moonblade/Water-level-indicator/README.md

# Water level indicator

[https://moonblade.github.io/blog/2021/09/11/over-engineering.html](https://moonblade.github.io/blog/2021/09/11/over-engineering.html)

A nodemcu tied to an ultrasonic sensor detects the distance to the water level at every ten seconds and uploads it to a firebase realtime db.

Android app, takes data from this db, and calculates current percentage based on min and max values it can have. Outlier values are discarded.

The app widget didn't really function as I wanted it to, so took a second nodemcu and created a water level indicator that takes data from firebase rtdb and displays it on an led matrix.

As an experiment in 3d printing and pcb printing, added eagle board schematic to print the water level indicator on pcb. Will end up removing the indicator and wire it up to relays to auto control the motor when water level is low.

### Update 2021-09-05

Bought a waterproof ultrasonic sensor, but the version supplied by the manufactorer seems to have some faults. One the minimum distance is too high and two it was giving random readings and not accurate ones. Which makes it unusable for this project. So ended up buying a new normal ultrasonic sensor and gave the waterproof one for return. But to learn previous lessons, figured would keep the sensor on top of the lid this time around so that corrosion doesn't play that big a role and it would be impossible for it to fall into water.

To that end, drilled a couple of holes in the lid of the water tank and stuck the sensor through it covering most of it with insulation tape. Also overhauled the microchip so that its easily replacable and works directly off of ac power doing its own coversion instead of relying on a phone charger.

Old vs new


Underside of lid


Topside connected up


### Update 2021-09-01 

The water level sensor was connected to the lid of hte water tank by threading it through the lid. The thread broke and the full box took a dip in the water and fried the electronics.
Till then it was getting a ton of water droplets on it due to evaporation as well. So the board looks really gnarly due to that.

For the updated version, will be using waterproof ultrasonic sensor and the ic will be kept seperate and not inside the lid anymore.



## Arduino code

### WaterLevelIndicator

Take data from firebase rtdb and display it on an 8x8 LED matrix based on value of printMode.





Installed in kitchen


### WaterLevelSensor

Get distance to water level and upload it to firebase rtdb.

Installed on the underside of the water tank lid. Had to do some rewiring of the electrical connections in the roof to provide uninterupted power bypassing a switch.


## App Screenshots

main
