moonblade/Water-level-indicator/screenshots/main.jpg

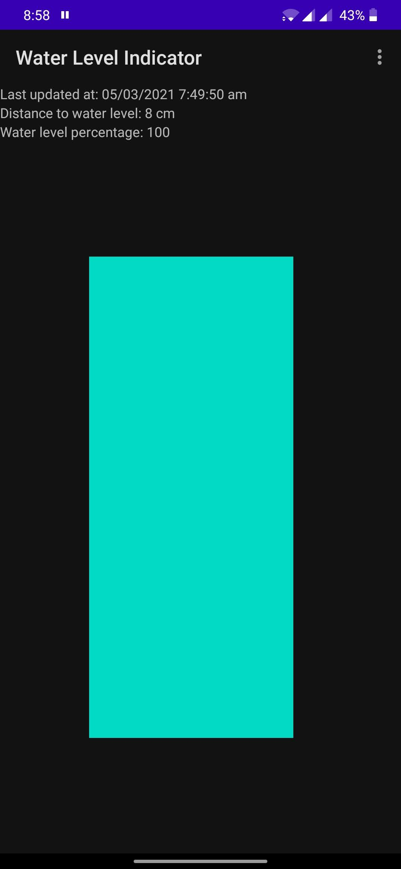
screenshots/main.jpg
