moonblade/Water-level-indicator/screenshots/settings.jpg

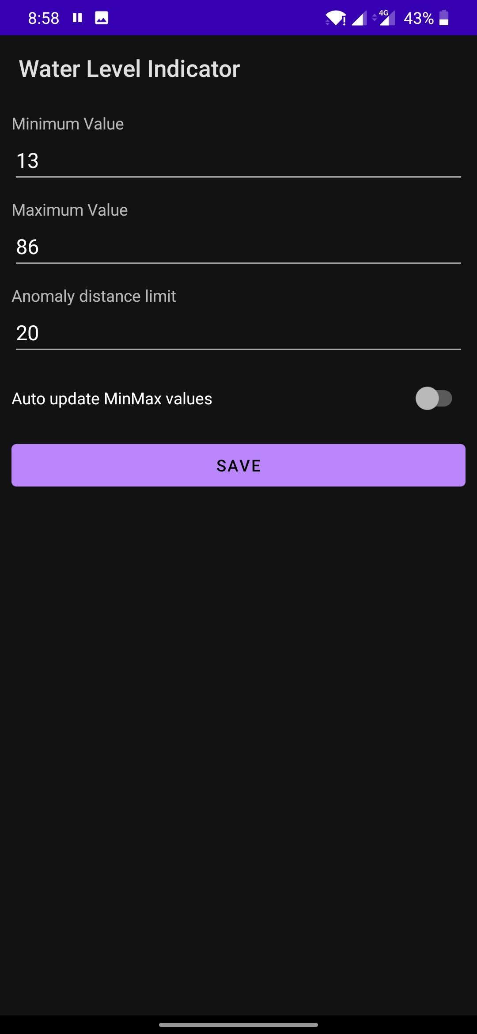
screenshots/settings.jpg
