moonblade/Water-level-indicator/eagle/WaterLevelIndicator.brd

## EAGLE design eagle/WaterLevelIndicator.brd (2021-05-04)

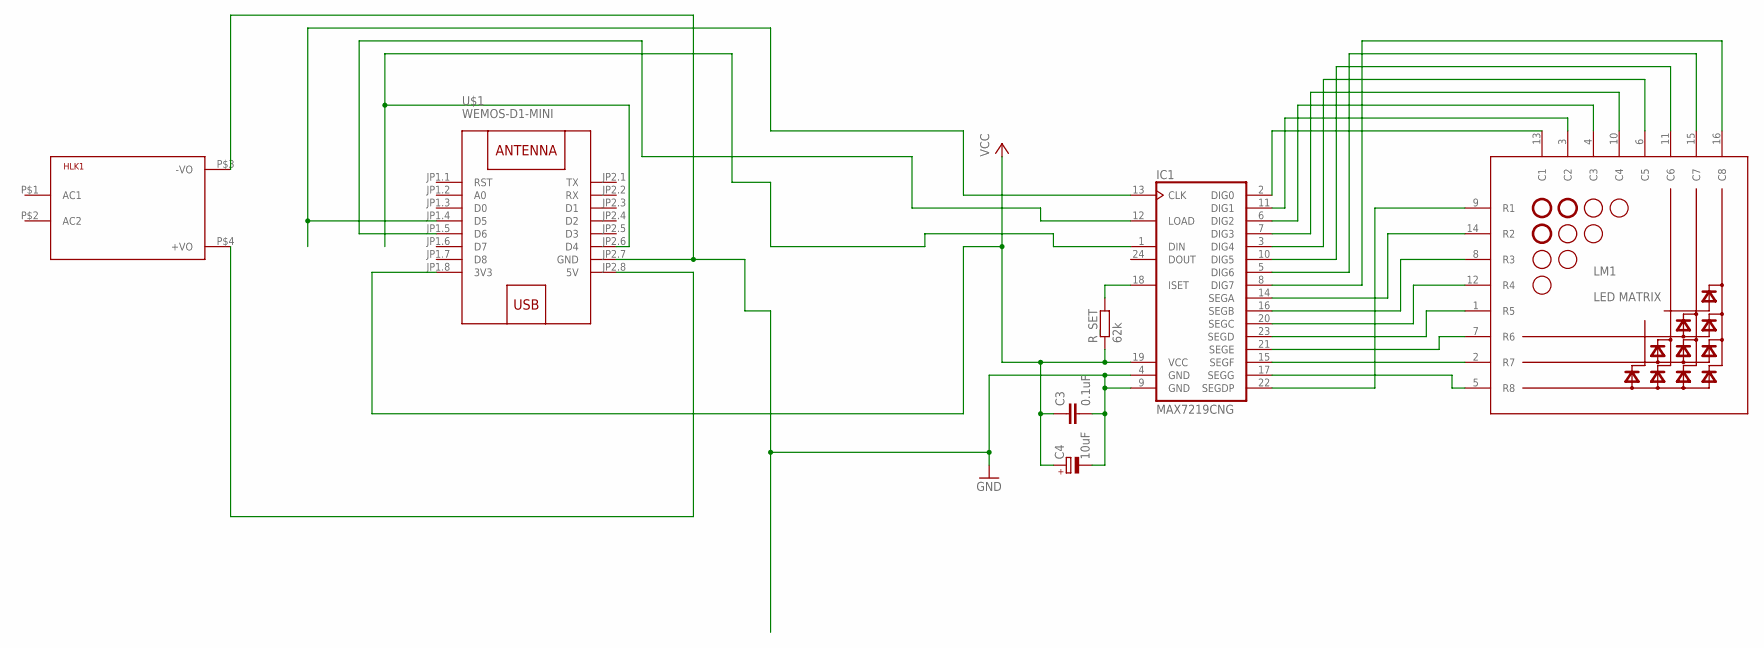
[picture p3: schematic WaterLevelIndicator.sch]

Parts:
C3: 0.1uF; C025-024X044
C4: 10uF; E2-5
HLK1: HLK-PM013W; HLK-PM01
IC1: MAX7219CNG; DIL24-3
LM1: LED MATRIX; LED_MATRIX
R_SET: 62k; 0207/10
U$1: WEMOS-D1-MINI

Connections:
GND: C3.2, C4.-, HLK1.P$3 (-VO), IC1.4 (GND), IC1.9 (GND), U$1.JP2.7 (GND)
unnamed: HLK1.P$4 (+VO), U$1.JP2.8 (5V)
unnamed: IC1.15 (SEGF), LM1.2 (R7)
unnamed: IC1.1 (DIN), U$1.JP2.6 (D4)
unnamed: IC1.12 (LOAD), U$1.JP1.5 (D6)
unnamed: IC1.13 (CLK), U$1.JP1.4 (D5)
unnamed: IC1.21 (SEGE), LM1.7 (R6)
unnamed: IC1.23 (SEGD), LM1.1 (R5)
unnamed: IC1.20 (SEGC), LM1.12 (R4)
unnamed: IC1.16 (SEGB), LM1.8 (R3)
unnamed: IC1.14 (SEGA), LM1.14 (R2)
unnamed: IC1.22 (SEGDP), LM1.9 (R1)
unnamed: IC1.8 (DIG7), LM1.16 (C8)
unnamed: IC1.5 (DIG6), LM1.15 (C7)
unnamed: IC1.10 (DIG5), LM1.11 (C6)
unnamed: IC1.3 (DIG4), LM1.6 (C5)
unnamed: IC1.7 (DIG3), LM1.10 (C4)
unnamed: IC1.6 (DIG2), LM1.4 (C3)
unnamed: IC1.11 (DIG1), LM1.3 (C2)
unnamed: IC1.2 (DIG0), LM1.13 (C1)
unnamed: IC1.18 (ISET), R_SET.2
unnamed: IC1.17 (SEGG), LM1.5 (R8)
VCC: C3.1, C4.+, IC1.19 (VCC), R_SET.1, U$1.JP1.8 (3V3)

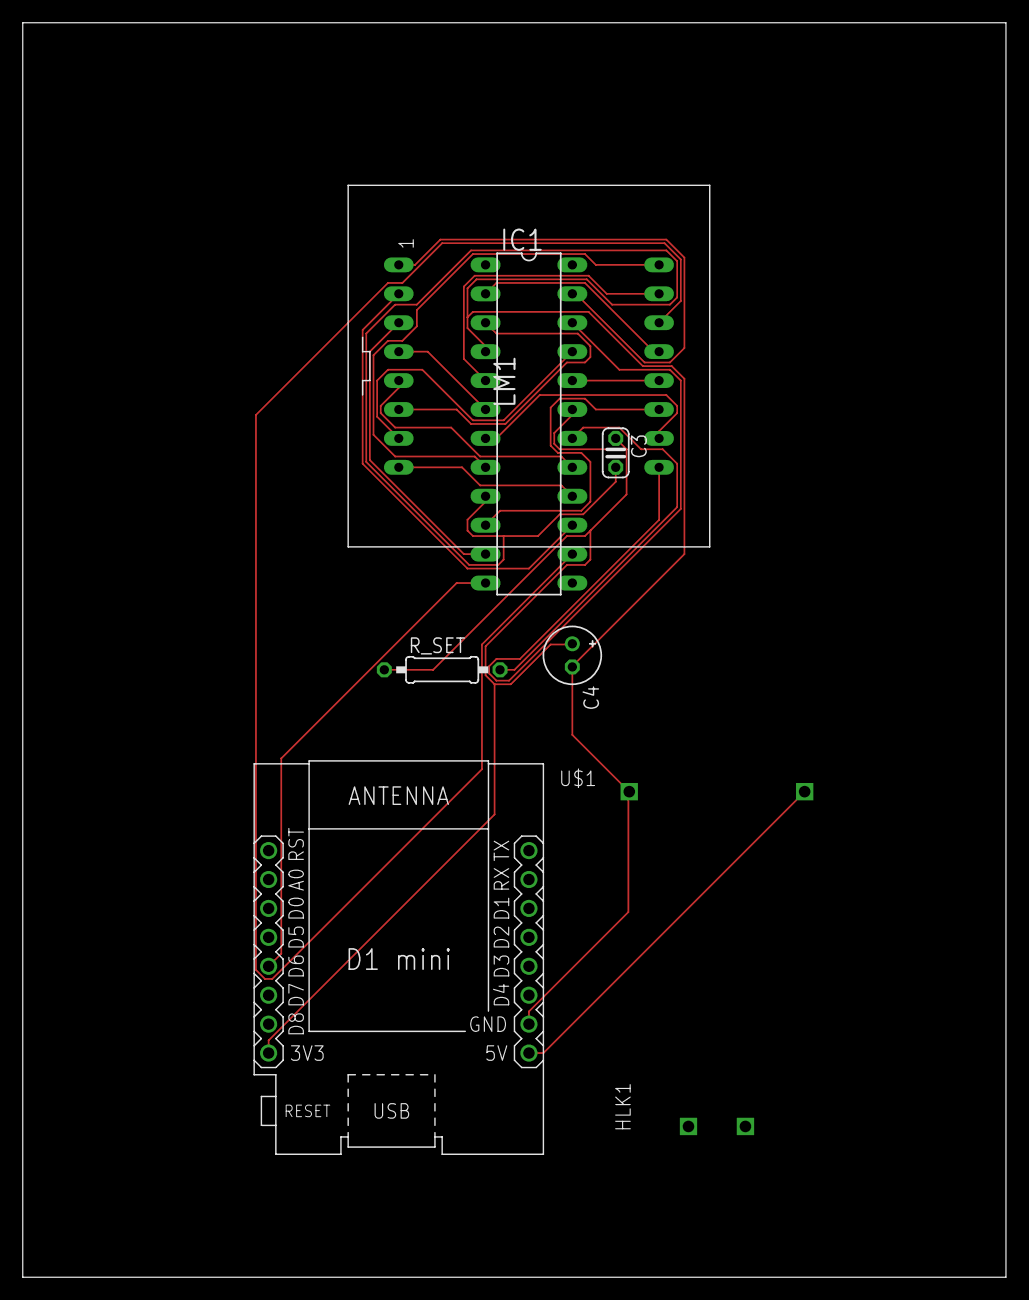
[picture p4: board WaterLevelIndicator.brd from above]

Board: 2 copper layers, 86.3 x 110.2 mm, 7 parts (0 on the bottom side), 23 nets.
