moonblade/Water-level-indicator/(commit log)

2021-05-02 add boards
    [WaterLevelIndicator.brd, WaterLevelIndicator.sch]
2021-05-03 added eagle schematics
    [WaterLevelIndicator.brd, WaterLevelIndicator.sch]
2021-05-03 more boards
2021-05-03 more optimization
    [WaterLevelIndicator.brd, WaterLevelIndicator.sch]
2021-05-03 add holes
    [WaterLevelIndicator.brd]
2021-05-04 need to add two jumpers
    [WaterLevelIndicator.brd]
2021-05-04 new board
    [WaterLevelIndicator.brd, WaterLevelIndicator.sch]
2021-05-05 final board?
2021-09-03 Update on broken sensor
2021-09-13 Direct mode wasn\'t working, fixes that
    [waterLevelIndicator.ino]
2021-09-16 Add auto update code to sensor as well
2021-09-16 Add mode calculation for more stability
    [waterLevelSensor.ino]
2021-10-02 Got it to work with waterproof sensor, finally
